mathewdunne/cad-mouse-mk2/pcbs/src/mcu_adapter_kicad/mcu_adapter.kicad_pcb

## KiCad design pcbs/src/mcu_adapter_kicad/mcu_adapter.kicad_pcb (2026-05-22)

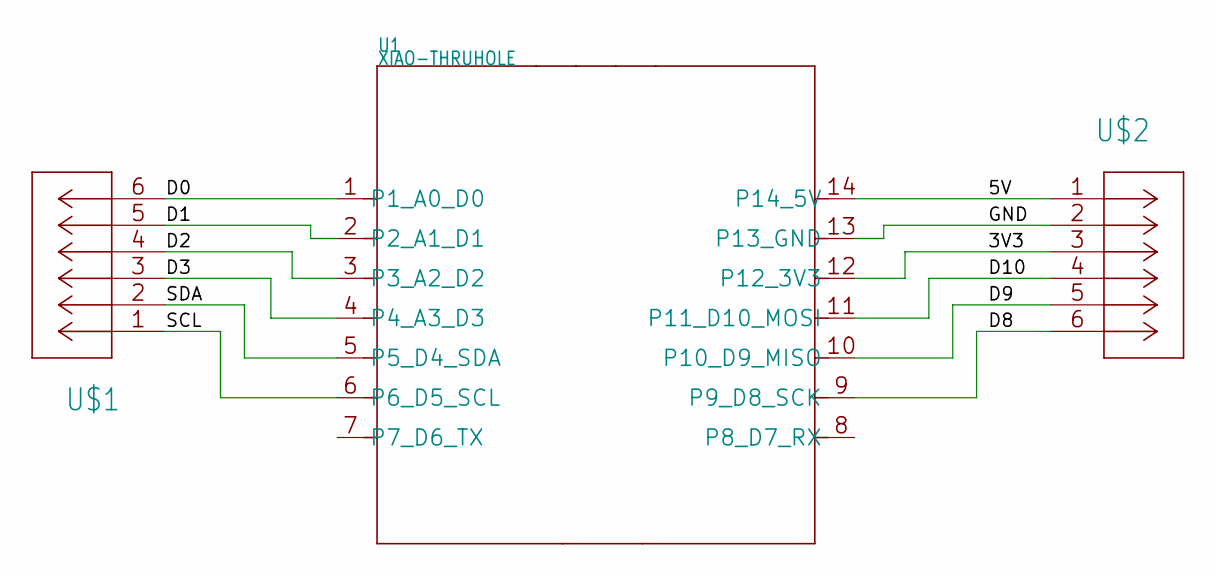
[picture p1: schematic mcu_adapter.kicad_sch]

Parts:
U1: XIAO-THRUHOLE; XIAO-GENERIC-THRUHOLE-MODULE14P-2.54-21X17.8MM
U$1, U$2: NRPN032PAEN-RC; CONN3X2_NRPN032PAEN-RC

Connections:
3V3: U1.12 (P12_3V3), U$2.3
5V: U1.14 (P14_5V), U$2.1
D0: U1.1 (P1_A0_D0), U$1.6
D1: U1.2 (P2_A1_D1), U$1.5
D2: U1.3 (P3_A2_D2), U$1.4
D3: U1.4 (P4_A3_D3), U$1.3
D8: U1.9 (P9_D8_SCK), U$2.6
D9: U1.10 (P10_D9_MISO), U$2.5
D10: U1.11 (P11_D10_MOSI), U$2.4
GND: U1.13 (P13_GND), U$2.2
SCL: U1.6 (P6_D5_SCL), U$1.1
SDA: U1.5 (P5_D4_SDA), U$1.2

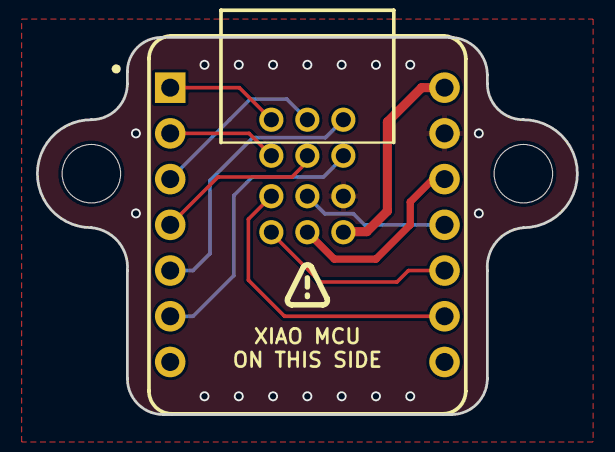
[picture p2: board mcu_adapter.kicad_pcb from above]

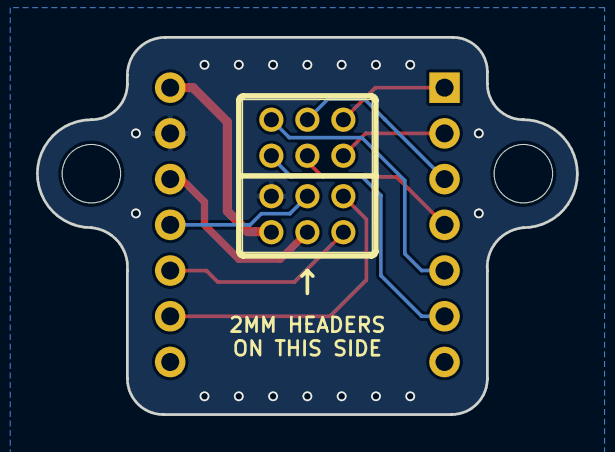
[picture p3: board mcu_adapter.kicad_pcb from below]

Board: 2 copper layers, 30.0 x 21.0 mm, 5 parts (2 on the bottom side), 12 nets.

Other parts of the board:
UNK_HOLE_0: dummyfp0
UNK_HOLE_1: dummyfp1
