mathewdunne/cad-mouse-mk2/firmware/include/Config.h

#pragma once

#include <Arduino.h>

namespace Config {

const bool ENABLE_TELEMETRY = true;
const bool ENABLE_CALIBRATION_SERIAL = true;

// Hardware pins (XIAO RP2040)
const int PIN_RIGHT_BTN = D0;
const int PIN_LEFT_BTN = D2;
const int PIN_LED_DATA = D3;
const int PIN_LED_LS = D1;
const int PIN_MAG1_LS = D10;
const int PIN_MAG2_LS = D9;
const int PIN_MAG3_LS = D8;

// Samples for calibration offset
const int ZERO_SAMPLES = 200;

// Gains and sign fixes
const float GAIN_T[3] = {28.0, 28.0, 24.0};
const float GAIN_R[3] = {18.0, 18.0, 20.0};
const int SIGN_AXIS[6] = {+1, -1, +1, -1, -1, -1};

// Dead zones
const float DEAD_T = 16.0;
const float DEAD_R = 20.0;

// Smoothing (one-pole low-pass time constant, seconds, per axis [Tx,Ty,Tz,Rx,Ry,Rz]).
// Longer tau = heavier smoothing = quieter but laggier. The low-SNR translation
// axes (Tx/Ty, see the calibration report) get more smoothing; the high-SNR
// rotations stay short so they remain responsive.
const float SMOOTH_TAU_S[6] = {0.132f, 0.128f, 0.073f, 0.149f, 0.02f, 0.034f};

// Final axis output range
const float AXIS_LIMIT = 350.0;

// RGB LEDs
const int LED_COUNT = 8;
const int LED_BRIGHTNESS = 40;
const unsigned long LED_IDLE_COLOR = 0x00FF00;
const unsigned long LED_CALIBRATING_COLOR = 0x0000FF;

// FSM timing
const long IDLE_SLEEP_TIMEOUT_MS = 2 * 60 * 1000;

}  // namespace Config
