mathewdunne/cad-mouse-mk2/(commit log)

2026-05-22 added kicad PCB schematics
    [bom.csv, designators.csv, mcu_adapter.kicad_pcb, mcu_adapter.kicad_sch, positions.csv, sensor_board.kicad_pcb, sensor_board.kicad_sch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]
2026-05-22 deleted kicad history file
2026-05-23 switched to active low
2026-06-15 created calibration script
2026-06-16 updated directions for calibration
